Even-lwx/HookWeightModule/pcb/ADS1232/HookWeightModule-Ver1.0/HookWeightModule-Ver1.0.xlsx

Name | Description | Designator | Footprint | LibRef | Quantity
螺丝孔_1 |  | *1, *2, *3, *4 | M3螺丝 | 螺丝孔_1 | 4
cc0402krx7r7bb104 | 容值:100nF;精度:±10%;额定电压:16V;温度系数:X7R; | C1, C3, C4, C6, C8, C10, C13 | C0402 | cc0402krx7r7bb104 | 7
cc0402jrnpo9bn180 | 容值:18pF;精度:±5%;额定电压:50V;温度系数:NP0; | C7, C9 | C0402 | cc0402jrnpo9bn180 | 2
cl21b103kbannnc | 容值:10nF;精度:±10%;额定电压:50V;温度系数:X7R; | C11, C12 | C0805 | cl21b103kbannnc | 2
cga0603x5r105k500jt | 容值:1uF;精度:±10%;额定电压:50V;温度系数:X5R; | C14, C15, C16, C17 | C0603 | cga0603x5r105k500jt | 4
pz254v-11-05p | 插针结构:1x5P;间距:2.54mm;行距:-;圆针/方针:方针;安装方式:直插;排数:单排;总PIN位数:5P;额定电流:3A;额定电压:250V;配合针长度:6mm;塑高:2.5mm;端接针长度:3mm;触头材质:黄铜;触头镀层:-;工作温度:-40℃~+105℃;颜色:黑色; | H1 | HDR-TH_5P-P2.54-V-M | pz254v-11-05p | 1
ltst-c190kskt | 灯头类型:-;发光颜色:黄色;正向压降(Vf):2.1V;功率:75mW;正向电流:20mA;波长:584.5nm~597nm;二极管配置:独立二极管;透镜颜色:无色透明透镜;色温:-;发光强度:104mcd;发光角度:130°;载带方式:-;工作温度:-30℃~+85℃; | LED1 | LED0603-RD | ltst-c190kskt | 1
frc0402f47r0ts | 电阻类型:厚膜电阻;阻值:47Ω;精度:±1%;功率:62.5mW;工作电压:50V;温度系数:±100ppm/℃; | R1, R2, R3 | R0402 | frc0402f47r0ts | 3
frc0603f1002ts | 电阻类型:厚膜电阻;阻值:10kΩ;精度:±1%;功率:100mW;工作电压:75V;温度系数:±100ppm/℃; | R4 | R0603 | frc0603f1002ts | 1
frc0603f1000ts | 电阻类型:厚膜电阻;阻值:100Ω;精度:±1%;功率:100mW;工作电压:75V;温度系数:±100ppm/℃; | R5, R6 | R0603 | frc0603f1000ts | 2
0603waf0000t5e | 电阻类型:厚膜电阻;阻值:0Ω;精度:±1%;功率:100mW;工作电压:75V;温度系数:-; | R7 | R0603 | 0603waf0000t5e | 1
0603waf1001t5e | 电阻类型:厚膜电阻;阻值:1kΩ;精度:±1%;功率:100mW;工作电压:75V;温度系数:±100ppm/℃; | R8 | R0603 | 0603waf1001t5e | 1
ts-1088-ar02016 | 电路结构:单刀单掷;按钮形状:圆形按钮;作用力:1.6N;安装方式:立贴;开关长度:3.9mm;开关宽度:3mm;开关高度:2mm;带支架:不带支架;触点电流:50mA;额定电压:12V;带灯:-;工作寿命:10万次; | SW1 | SW-SMD_L3.9-W3.0-P4.45 | ts-1088-ar02016 | 1
ads1232ipwr | 分辨率(位):24;采样率:10Hz;工作电压:2.7V~5.3V;接口类型:SPI; | U2 | TSSOP-24_L7.8-W4.4-P0.65-LS6.4-BL | ads1232ipwr | 1
stm32g031c8t6 | CPU内核:ARM Cortex-M0+;CPU最大主频:64MHz;CPU位数:32 Bit; | U3 | LQFP-48_L7.0-W7.0-P0.50-LS9.0-BL | stm32g031c8t6 | 1
5个焊盘 |  | U4 | 5个焊盘 - duplicate | 5个焊盘 | 1
tps7a2033pdbvr | 输出类型:固定;最大输入电压:6V;输出电压:3.3V;输出电流:300mA;输出极性:正极; | U5 | SOT-23-5_L2.9-W1.6-P0.95-LS2.8-BR | tps7a2033pdbvr | 1
tps7a2050pdbvr | 输出极性:正极;工作电压:6V;输出电压:5V;输出电流:300mA;电源纹波抑制比(PSRR):65dB@(100Hz);输出类型:固定; | U6 | SOT-23-5_L2.9-W1.6-P0.95-LS2.8-BR | tps7a2050pdbvr | 1
bx-xh2.54-4pwt | 插针结构:1x4P;间距:2.5mm;安装方式:卧贴;参考系列:XH;总PIN数:4P;排数:1;每排PIN数:4;行距:-;额定电流:3A;触头材质:黄铜;触头镀层:锡;工作温度:-25℃~+85℃; | U7 | CONN-SMD_4P-P2.50_BX-XH2.54-4PWT | bx-xh2.54-4pwt | 1
x32258mob4si | 晶振类型:贴片晶振;频率:8MHz;常温频差:±10ppm;负载电容:12pF;频率稳定度:±20ppm; | X1 | CRYSTAL-SMD_4P-L3.2-W2.5-BL | x32258mob4si | 1
