Even-lwx/HookWeightModule/(list of files, drawings)

Other design files:
pcb/ADS1232/ad - 08281439/PCB_Project/P1.schdoc
pcb/ADS1232/ad - 08281439/PCB_Project/PCB1.PcbDoc
pcb/ADS1232/ad - 08281439/PCB_Project/PCB_Project.PrjPcb
pcb/ADS1232/ad - 08281439/PCB_Project/Sheet1.SchDoc
pcb/ADS1232/ad/PCB_Project/P1.schdoc
pcb/ADS1232/ad/PCB_Project/PCB1.PcbDoc
pcb/ADS1232/ad/PCB_Project/PCB_Project.PrjPcb
pcb/ADS1232/ad/PCB_Project/Sheet1.SchDoc
pcb/ADS1232/Altium_ADS1232_2026-08-26/ADS1232/Board1/PCB1.pcbdoc
pcb/ADS1232/HookWeightModule-Ver1.0/HookWeightModule-Ver1.0.PrjPcb
pcb/ADS1232/HookWeightModule-Ver1.0/PCB1.PcbDoc
pcb/ADS1232/HookWeightModule-Ver1.0/Sheet1.SchDoc
pcb/ADS1232/嘉立创导出封装/5个焊盘.pcbdoc
pcb/ADS1232/嘉立创导出封装/5个焊盘.schdoc
pcb/ADS1232/嘉立创导出封装/0603WAF0000T5E.schdoc
pcb/ADS1232/嘉立创导出封装/0603WAF470JT5E.schdoc
pcb/ADS1232/嘉立创导出封装/ADS1232IPW.schdoc
pcb/ADS1232/嘉立创导出封装/C0402 (1).pcbdoc
pcb/ADS1232/嘉立创导出封装/C0402 (2).pcbdoc
pcb/ADS1232/嘉立创导出封装/C0603.pcbdoc
pcb/ADS1232/嘉立创导出封装/CC0402JRNPO9BN180.schdoc
pcb/ADS1232/嘉立创导出封装/CC0402JRNPO9BN220.schdoc
pcb/ADS1232/嘉立创导出封装/CC0402KRX7R7BB104.schdoc
pcb/ADS1232/嘉立创导出封装/CGA0603X5R105K500JT.schdoc
pcb/ADS1232/嘉立创导出封装/CGA0603X7R104K500JT.schdoc
pcb/ADS1232/嘉立创导出封装/CRYSTAL-SMD_4P-L3.2-W2.5-BL.pcbdoc
pcb/ADS1232/嘉立创导出封装/CRYSTAL-SMD_L3.2-W1.5.pcbdoc
pcb/ADS1232/嘉立创导出封装/FC31M2-32.768-NTLNNDTL.schdoc
pcb/ADS1232/嘉立创导出封装/FCC0603B103K500CT.schdoc
pcb/ADS1232/嘉立创导出封装/FRC0402F47R0TS.schdoc
pcb/ADS1232/嘉立创导出封装/FRC0402F1000TS.schdoc
pcb/ADS1232/嘉立创导出封装/FRC0603F1000TS.schdoc
pcb/ADS1232/嘉立创导出封装/FRC0603F1002TS.schdoc
pcb/ADS1232/嘉立创导出封装/GCM155R71H103KA55D.schdoc
pcb/ADS1232/嘉立创导出封装/HDR-TH_4P-P2.54-V-M.pcbdoc
pcb/ADS1232/嘉立创导出封装/HDR-TH_5P-P2.54-V-M.pcbdoc
pcb/ADS1232/嘉立创导出封装/HX PZ2.54-1X4P ZZ.schdoc
pcb/ADS1232/嘉立创导出封装/LQFP-48_L7.0-W7.0-P0.50-LS9.0-BL.pcbdoc
pcb/ADS1232/嘉立创导出封装/M3螺丝.pcbdoc
pcb/ADS1232/嘉立创导出封装/PT1000焊盘.pcbdoc
pcb/ADS1232/嘉立创导出封装/PT1000焊盘.schdoc
pcb/ADS1232/嘉立创导出封装/PZ254V-11-05P.schdoc
pcb/ADS1232/嘉立创导出封装/R0402 (2).pcbdoc
pcb/ADS1232/嘉立创导出封装/R0603.pcbdoc
pcb/ADS1232/嘉立创导出封装/SOT-23-5_L2.9-W1.6-P0.95-LS2.8-BR.pcbdoc
pcb/ADS1232/嘉立创导出封装/STM32G031C8T6.schdoc
pcb/ADS1232/嘉立创导出封装/SW-SMD_L3.9-W3.0-P4.45.pcbdoc
pcb/ADS1232/嘉立创导出封装/TPS7A2033PDBVR.schdoc
pcb/ADS1232/嘉立创导出封装/TPS7A2050PDBVR.schdoc
pcb/ADS1232/嘉立创导出封装/TS-1088-AR02016.schdoc
pcb/ADS1232/嘉立创导出封装/TSSOP-24_L7.8-W4.4-P0.65-LS6.4-BL.pcbdoc
pcb/ADS1232/嘉立创导出封装/X32258MOB4SI.schdoc
pcb/ADS1232/嘉立创导出封装/螺丝孔_1.schdoc
