Even-lwx/HookWeightModule/code/STM32G031C8T6/Core/Src/main.c

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
/* Includes ------------------------------------------------------------------*/
#include "main.h"
#include "usart.h"
#include "gpio.h"

/* USER CODE BEGIN Includes */
#include "ads1232.h"
#include "ads1232_service.h"
#include "weight_processor.h"
#include "weight_storage.h"
#include "serial_debug.h"

/* USER CODE END Includes */


void SystemClock_Config(void);
/**
  * @brief  The application entry point.
  * @retval int
  */
int main(void)
{
  /* MCU Configuration--------------------------------------------------------*/

  /* Reset of all peripherals, Initializes the Flash interface and the Systick. */
  HAL_Init();

  /* Configure the system clock */
  SystemClock_Config();

  /* Initialize all configured peripherals */
  MX_GPIO_Init();
  MX_USART1_UART_Init();
  /* USER CODE BEGIN 2 */
  (void)ADS1232_Init();
  WeightProcessor_Init();
  WeightStorage_Init();
  SerialDebug_Init(&huart1);

  /* USER CODE END 2 */

  /* Infinite loop */
  /* USER CODE BEGIN WHILE */
  while (1)
  {
    /* USER CODE END WHILE */

    /* USER CODE BEGIN 3 */
    SerialDebug_Process();
    ADS1232_Service10Hz(&huart1, SerialDebug_OutputEnabled());
  }
  /* USER CODE END 3 */
}

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
