Even-lwx/HookWeightModule/code/STM32G031C8T6/STM32G031C8T6.ioc

Mcu.UserName=STM32G031C8Tx
PA10.Signal=USART1_RX
PA13.Signal=SYS_SWDIO
PA14-BOOT0.Signal=SYS_SWCLK
PA9.Signal=USART1_TX
PB0.Signal=GPIO_Input
PB1.Signal=GPIO_Output
PB2.Signal=GPIO_Output
