Even-lwx/HookWeightModule/code/STM32G031C8T6/code/Filter/weight_processor.c

#include "weight_processor.h"
#include "weight_calibration.h"
#include <stddef.h>
#include <string.h>

/* 上电动态零点补偿开关：
 * 0：关闭，整个运行期间使用固定的上电零点；
 * 1：开启，按照上电时间查表并插值补偿零点。 */
#define WEIGHT_DYNAMIC_ZERO_ENABLE       1U

#define MEDIAN_WINDOW_SIZE              5U
#define STABILITY_WINDOW_SIZE          10U
#define STABILITY_REQUIRED_SAMPLES     20U
/* 校准取点允许更快确认，正常 result->stable 仍使用上面的严格阈值。 */
/* 校准取点比正常显示使用更宽松的稳定条件，减少现场等待时间。 */
#define CALIBRATION_REQUIRED_SAMPLES    5U
#define CALIBRATION_STABLE_RANGE_COUNTS 216L
#define CALIBRATION_END_TO_END_COUNTS    48L

/* 以下阈值按照传感器约538 counts/g的灵敏度设置。 */
#define FAST_ENTER_COUNTS            1076L  /* 约2.0 g，进入快速跟随模式 */
#define FAST_EXIT_COUNTS              161L  /* 约0.3 g，准备退出快速模式 */
#define FAST_EXIT_REQUIRED_SAMPLES      5U
#define STABLE_RANGE_COUNTS            108L  /* 稳定窗口极差约0.2 g */
#define STABLE_END_TO_END_COUNTS        24L  /* 0.9秒内变化约不超过0.05 g/s */
#define OVER_RANGE_MIN_X10                0L
#define OVER_RANGE_MAX_X10            10000L

/* 第二级：一维标量卡尔曼滤波（常数位+随机游走模型），全程定点无浮点。
 * 输入为5点中值结果。依据10Hz静止日志，中值5后残差噪声标准差约10~12 counts，
 * 测量噪声方差 R 取 144（counts^2）。静止时 Q_SLOW=16，稳态 P=sqrt(R*Q)=48，
 * 稳态增益 K=P/(P+R)=0.25，平滑力度与上位机参考滤波I1相当；重量阶跃期间切到
 * Q_FAST=144（K约0.50）快速跟随，并在进入快速档瞬间抬升P避免第一拍滞后。
 * 参数依据 log/新传感器测长时间稳定性 与 log/新传感器新PCB 实测数据标定。 */
#define KALMAN_MEAS_NOISE_R             144L
#define KALMAN_PROCESS_NOISE_Q_SLOW      8L
#define KALMAN_PROCESS_NOISE_Q_FAST     144L
#define KALMAN_INIT_P                    48L
#define KALMAN_FAST_P_BOOST             144L
#define KALMAN_Q16_ONE                65536L

typedef struct {
    int32_t median_values[MEDIAN_WINDOW_SIZE];
    int32_t stability_values[STABILITY_WINDOW_SIZE];
    int64_t filtered_q8;
    int32_t kf_p;                       /* 卡尔曼估计协方差P，单位counts^2 */
    int32_t last_filtered_raw;
    uint32_t fallback_elapsed_ms;
    int32_t manual_tare_offset;
    int32_t current_profile_zero;
    uint8_t median_count;
    uint8_t median_index;
    uint8_t stability_count;
    uint8_t stability_index;
    uint8_t stable_qualified_count;
    uint8_t calibration_qualified_count;
    uint8_t fast_exit_count;
    uint8_t filter_initialized;
    uint8_t fast_mode;
    uint8_t ready;
    uint8_t stable;
} WeightProcessor_State;

static WeightProcessor_State processor;
static WeightProcessor_Result last_result;

static int64_t Abs64(int64_t value)
{
    return (value < 0) ? -value : value;
}

static int32_t Median5(const int32_t *values)
{
    int32_t sorted[MEDIAN_WINDOW_SIZE];
    uint8_t i;
    uint8_t j;
    int32_t key;

    for (i = 0U; i < MEDIAN_WINDOW_SIZE; ++i) {
        sorted[i] = values[i];
    }

    /* 固定5点插入排序后取中间值，用来抑制单点尖峰；10Hz下开销可忽略。 */
    for (i = 1U; i < MEDIAN_WINDOW_SIZE; ++i) {
        key = sorted[i];
        j = i;
        while ((j > 0U) && (sorted[j - 1U] > key)) {
            sorted[j] = sorted[j - 1U];
            --j;
        }
        sorted[j] = key;
    }
    return sorted[MEDIAN_WINDOW_SIZE / 2U];
}

static int32_t UpdateMedian(int32_t raw)
{
    processor.median_values[processor.median_index] = raw;
    processor.median_index = (uint8_t)((processor.median_index + 1U) %
                                       MEDIAN_WINDOW_SIZE);

    if (processor.median_count < MEDIAN_WINDOW_SIZE) {
        ++processor.median_count;
        return raw;
    }

    return Median5(processor.median_values);
}

static int32_t UpdateKalman(int32_t median_raw)
{
    int64_t target_q8;
    int64_t innovation_q8;
    int64_t difference_counts;
    int32_t process_noise_q;
    int32_t innovation_variance;
    int32_t gain_q16;

    /* 状态值使用Q8定点保存，避免在Cortex-M0+上引入浮点运算。 */
    target_q8 = (int64_t)median_raw * 256L;
    if (!processor.filter_initialized) {
        processor.filtered_q8 = target_q8;
        processor.kf_p = (int32_t)KALMAN_INIT_P;
        processor.filter_initialized = 1U;
        return median_raw;
    }

    innovation_q8 = target_q8 - processor.filtered_q8;
    difference_counts = Abs64(innovation_q8) / 256L;

    /* 变化较大时快速跟随真实重量阶跃；变化较小时加强平滑。 */
    if (difference_counts > FAST_ENTER_COUNTS) {
        processor.fast_mode = 1U;
        processor.fast_exit_count = 0U;
    } else if (processor.fast_mode) {
        if (difference_counts < FAST_EXIT_COUNTS) {
            if (processor.fast_exit_count < FAST_EXIT_REQUIRED_SAMPLES) {
                ++processor.fast_exit_count;
            }
            if (processor.fast_exit_count >= FAST_EXIT_REQUIRED_SAMPLES) {
                processor.fast_mode = 0U;
                processor.fast_exit_count = 0U;
            }
        } else {
            processor.fast_exit_count = 0U;
        }
    }

    /* 预测步：P^- = P + Q，快速档使用更大的过程噪声以提高增益。 */
    process_noise_q = processor.fast_mode ?
                      (int32_t)KALMAN_PROCESS_NOISE_Q_FAST :
                      (int32_t)KALMAN_PROCESS_NOISE_Q_SLOW;
    processor.kf_p += process_noise_q;
    /* 刚进入快速档时立即把P抬升，让阶跃第一拍就有约0.5的增益。 */
    if (processor.fast_mode &&
        (processor.kf_p < (int32_t)KALMAN_FAST_P_BOOST)) {
        processor.kf_p = (int32_t)KALMAN_FAST_P_BOOST;
    }

    /* 更新步：K = P^- / (P^- + R)，增益用Q16定点表示。 */
    innovation_variance = processor.kf_p + (int32_t)KALMAN_MEAS_NOISE_R;
    gain_q16 = (int32_t)(((int64_t)processor.kf_p * KALMAN_Q16_ONE) /
                         innovation_variance);
    /* x = x^- + K * (z - x^-) */
    processor.filtered_q8 += (innovation_q8 * (int64_t)gain_q16) /
                             KALMAN_Q16_ONE;
    /* P = (1 - K) * P^- */
    processor.kf_p -= (int32_t)(((int64_t)processor.kf_p * gain_q16) /
                                KALMAN_Q16_ONE);

    if (processor.filtered_q8 >= 0) {
        return (int32_t)((processor.filtered_q8 + 128L) / 256L);
    }
    return (int32_t)((processor.filtered_q8 - 128L) / 256L);
}

static void UpdateStability(int32_t filtered_raw)
{
    uint8_t i;
    uint8_t oldest_index;
    uint8_t newest_index;
    int32_t minimum;
    int32_t maximum;
    int32_t end_to_end;

    /* 检查最近10点的极差和首尾差，连续满足条件后判定为稳定。 */
    processor.stability_values[processor.stability_index] = filtered_raw;
    processor.stability_index = (uint8_t)((processor.stability_index + 1U) %
                                          STABILITY_WINDOW_SIZE);
    if (processor.stability_count < STABILITY_WINDOW_SIZE) {
        ++processor.stability_count;
        processor.stable = 0U;
        return;
    }

    minimum = processor.stability_values[0];
    maximum = processor.stability_values[0];
    for (i = 1U; i < STABILITY_WINDOW_SIZE; ++i) {
        if (processor.stability_values[i] < minimum) {
            minimum = processor.stability_values[i];
        }
        if (processor.stability_values[i] > maximum) {
            maximum = processor.stability_values[i];
        }
    }

    oldest_index = processor.stability_index;
    newest_index = (uint8_t)((processor.stability_index +
                              STABILITY_WINDOW_SIZE - 1U) %
                             STABILITY_WINDOW_SIZE);
    end_to_end = processor.stability_values[newest_index] -
                 processor.stability_values[oldest_index];
    if (end_to_end < 0) {
        end_to_end = -end_to_end;
    }

    if (((maximum - minimum) <= STABLE_RANGE_COUNTS) &&
        (end_to_end <= STABLE_END_TO_END_COUNTS) &&
        !processor.fast_mode) {
        if (processor.stable_qualified_count < STABILITY_REQUIRED_SAMPLES) {
            ++processor.stable_qualified_count;
        }
    } else {
        processor.stable_qualified_count = 0U;
    }
    processor.stable =
        (processor.stable_qualified_count >= STABILITY_REQUIRED_SAMPLES) ? 1U : 0U;

    /* 校准取点使用较宽的窗口和较少的连续样本，避免现场等待过久；
       该状态不会改变正常输出中的 stable 标志。 */
    if (((maximum - minimum) <= CALIBRATION_STABLE_RANGE_COUNTS) &&
        (end_to_end <= CALIBRATION_END_TO_END_COUNTS) &&
        !processor.fast_mode) {
        if (processor.calibration_qualified_count < CALIBRATION_REQUIRED_SAMPLES) {
            ++processor.calibration_qualified_count;
        }
    } else {
        processor.calibration_qualified_count = 0U;
    }
}

void WeightProcessor_Init(void)
{
    memset(&processor, 0, sizeof(processor));
    WeightCalibration_Init();
}

void WeightProcessor_Reset(void)
{
    WeightProcessor_Init();
}

uint8_t WeightProcessor_Update(int32_t raw, WeightProcessor_Result *result)
{
    uint8_t ready;

    ready = WeightProcessor_UpdateTimed(raw, processor.fallback_elapsed_ms,
                                        result);
    if (processor.fallback_elapsed_ms <= (0xFFFFFFFFUL - 100UL)) {
        processor.fallback_elapsed_ms += 100UL;
    }
    return ready;
}

uint8_t WeightProcessor_UpdateTimed(int32_t raw, uint32_t elapsed_ms,
                                    WeightProcessor_Result *result)
{
    int32_t median_raw;
    int32_t filtered_raw;
    int32_t weight_x10;
    int32_t weight_x1000;

    if (result == NULL) {
        return 0U;
    }

    /* 第一级：5点中值滤波抑制单点尖峰；第二级：标量卡尔曼平滑并快速跟随阶跃。 */
    median_raw = UpdateMedian(raw);
    filtered_raw = UpdateKalman(median_raw);
    processor.last_filtered_raw = filtered_raw;
    UpdateStability(filtered_raw);

    /* 只使用提前记录并写入 Flash 的空载零点。
     * 当前ADC值可能包含真实负载，因此不能反馈到零点计算中。 */
    #if (WEIGHT_DYNAMIC_ZERO_ENABLE != 0U)
    if (WeightCalibration_IsManual()) {
        processor.current_profile_zero = WeightCalibration_GetZeroRaw();
    } else {
        processor.current_profile_zero =
            WeightCalibration_GetFlashZeroRaw(elapsed_ms);
    }
    #else
    /* 关闭动态补偿时固定使用0秒节点，不随时间改变。 */
    (void)elapsed_ms;
    processor.current_profile_zero = WeightCalibration_GetFlashZeroRaw(0UL);
    #endif
    if (WeightCalibration_IsManual()) {
        WeightCalibration_SetZeroRaw(processor.current_profile_zero);
    } else {
        WeightCalibration_SetZeroRaw(processor.current_profile_zero +
                                     processor.manual_tare_offset);
    }
    weight_x10 = WeightCalibration_Convert(filtered_raw);
    weight_x1000 = WeightCalibration_ConvertX1000(filtered_raw);
    processor.ready = 1U;

    result->raw = raw;
    result->filtered_raw = filtered_raw;
    result->median_raw = median_raw;
    result->weight_x10 = weight_x10;
    result->weight_x1000 = weight_x1000;
    result->ready = processor.ready;
    result->stable = processor.stable;
    result->over_range = ((weight_x10 < OVER_RANGE_MIN_X10) ||
                          (weight_x10 > OVER_RANGE_MAX_X10)) ? 1U : 0U;
    last_result = *result;

    return processor.ready;
}

const WeightProcessor_Result *WeightProcessor_GetLastResult(void)
{
    return &last_result;
}

uint8_t WeightProcessor_IsCalibrationStable(void)
{
    /* 该接口只服务于 zero/cal/point，不改变对外结果中的 stable 标志。 */
    if (!processor.ready) {
        return 0U;
    }
    if (processor.stable) {
        return 1U;
    }
    return (processor.calibration_qualified_count >= CALIBRATION_REQUIRED_SAMPLES) ? 1U : 0U;
}

uint8_t WeightProcessor_Tare(void)
{
    if (!processor.ready || !processor.stable) {
        return 0U;
    }

    /* 手动去皮值作为固定偏移叠加在 Flash 动态零点曲线上。
     * 复位或重新上电后自动清除本次手动去皮值。 */
    processor.manual_tare_offset = processor.last_filtered_raw -
                                   processor.current_profile_zero;
    WeightCalibration_SetZeroRaw(processor.last_filtered_raw);
    return 1U;
}
