Even-lwx/HookWeightModule/(commit log)

2026-09-01 Rawdata可以读取到数据了
2026-09-01 转成fire water发送
2026-09-01 整理一下项目文件
2026-09-01 feat: 完成ADS1232重量采集、滤波、动态零点及全局线性标定
    - 实现ADS1232 24位数据读取与10Hz串口输出
    - 增加三点中值和自适应IIR滤波
    - 增加稳定状态检测与手动去皮
    - 使用Flash时间曲线补偿上电零漂
    [250901-1016-带袋静止零漂.csv, 250901-1025-0克静止零漂.csv, 250901-1031-10克静止零漂.csv, 250901-1042-50克静止零漂.csv, 250901-1048-100克静止零漂.csv, 250901-1055-200克静止零漂.csv, 250901-1059-500克静止零漂.csv, 250901-1105-700克静止零漂.csv]
2026-09-02 增加了一个开关动态零点的宏定义WEIGHT_DYNAMIC_ZERO_ENABLE
2026-09-02 计算斜率优化
2026-09-02 通过串口实现零件校准，特定重量校准，斜率校准（多点最小二乘法）
2026-09-02 feat(menu):增加快捷零点校准，不需要进入debug模式，直接发送quick zero即可开始校准且自动保存
2026-09-02 feat(menu):增加快捷指定克重校准，不需要进入debug模式，直接发送quick cal <克重> 即可开始校准且自动保存
2026-09-03 整理项目目录并加入PCB和代码
    [0603WAF0000T5E.schdoc, 0603WAF470JT5E.schdoc, 250901-1016-带袋静止零漂.csv, 250901-1025-0克静止零漂.csv, 250901-1031-10克静止零漂.csv, 250901-1042-50克静止零漂.csv, 250901-1048-100克静止零漂.csv, 250901-1055-200克静止零漂.csv]
2026-09-10 串口发送的重量数据修改为3位小数
2026-09-10 串口发送的重量数据修改为3位小数
    - weight_calibration/weight_processor 新增 weight_x1000（0.001g）输出
    - ads1232_service 串口输出由 weight_x10(0.1g) 切换为 weight_x1000，小数部分按 %03ld 补零
2026-09-10 重量滤波改为5点中值+定点卡尔曼滤波
    - 第一级中值滤波窗口由3点扩大到5点，增强单点尖峰抑制能力
    - 第二级由自适应IIR改为一维标量卡尔曼滤波，全程Q8/Q16整数定点，不引入浮点
    - 卡尔曼Q/R参数依据新传感器长时间稳定性、新PCB实测10Hz日志标定，静止稳态增益0.25，并保留重量阶跃时的快速跟随
2026-09-11 增加五点中值与卡尔曼重量滤波输出
2026-11-05 将项目说明和注释统一为中文
2026-11-05 完善中文工程文档和注释
2026-11-06 整理称重分析结果目录并完善忽略规则
