Even-lwx/HookWeightModule/(notices)

Notices in the files:
code/STM32G031C8T6/Core/Src/main.c:
Copyright (c) 2026 STMicroelectronics.
All rights reserved.
This software is licensed under terms that can be found in the LICENSE file
